raphaeltournafond/STM-Auto/kicad/stm-auto/stm-auto.kicad_sch

## KiCad design kicad/stm-auto/stm-auto.kicad_sch (2026-06-14, an earlier design)

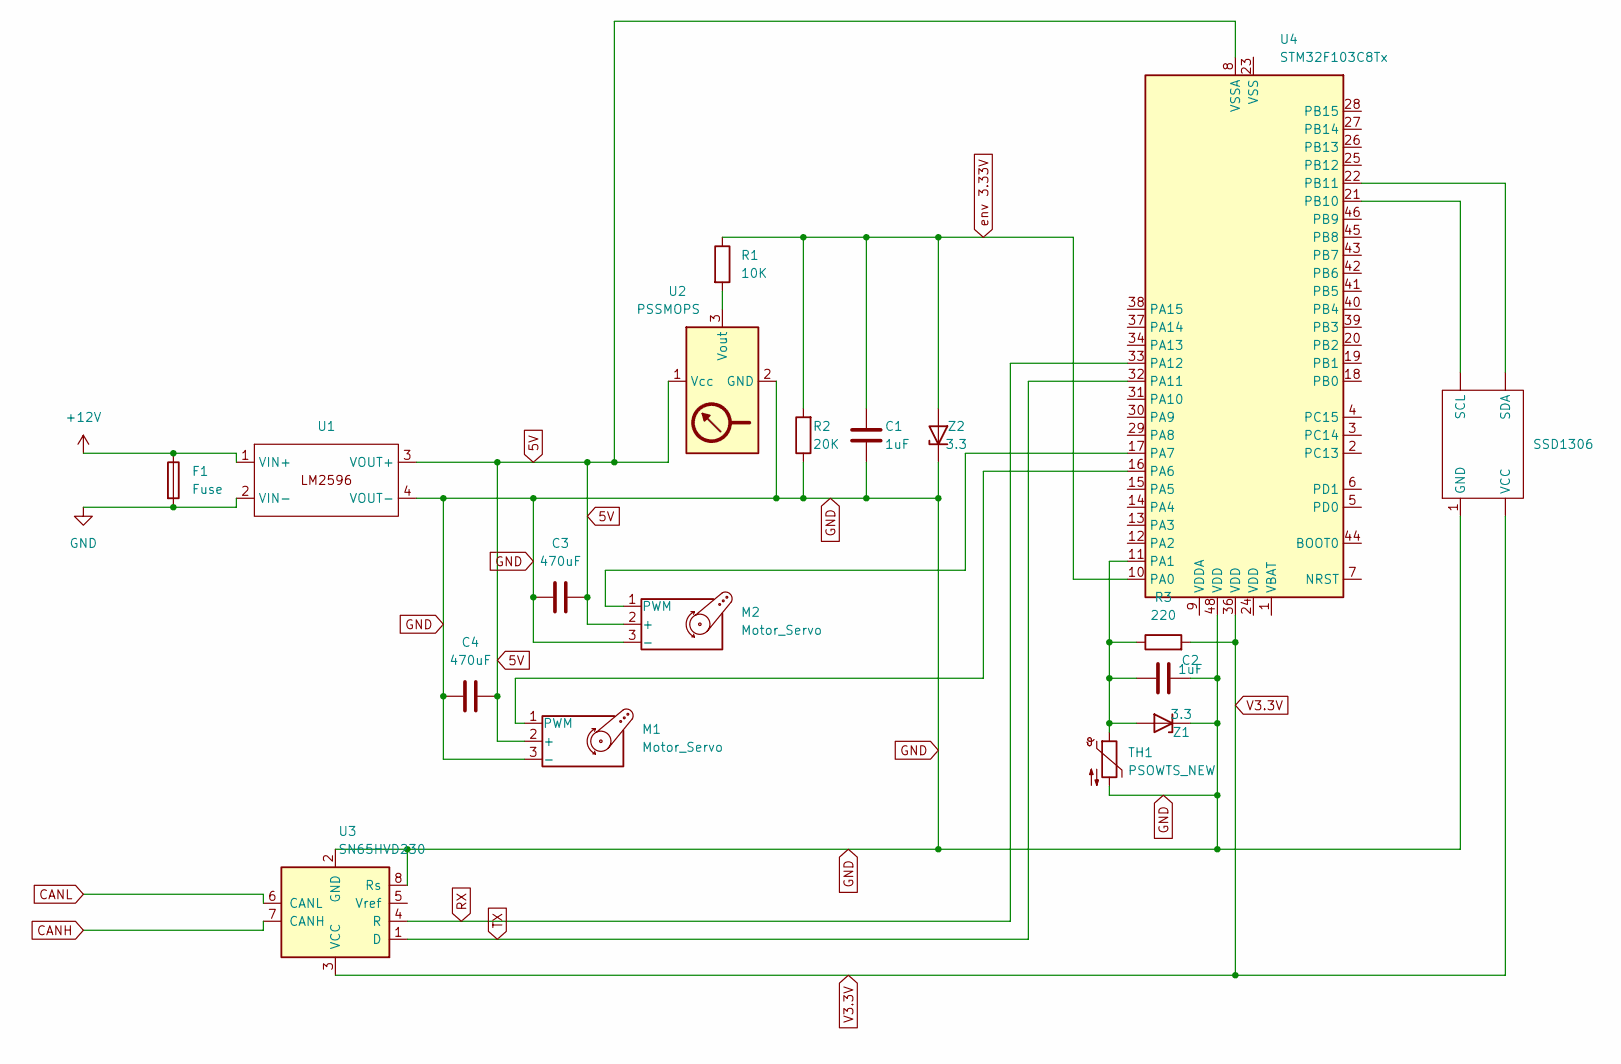
[picture p1: schematic stm-auto.kicad_sch]

Parts:
C1, C2: 1uF
C3, C4: 470uF
F1: Fuse
M1, M2: Motor_Servo
R1: 10K
R2: 20K
R3: 220
SSD1306: (no value)
TH1: PSOWTS_NEW
U1: (no value)
U2: PSSMOPS
U3: SN65HVD230; SOIC-8_3.9x4.9mm_P1.27mm
U4: STM32F103C8Tx; LQFP-48_7x7mm_P0.5mm
Z1, Z2: 3.3

Connections:
5V: C3.2, C4.2, M1.2 (+), M2.2 (+), U1.3 (VOUT+), U2.1 (Vcc), U4.8 (VSSA)
+12V: F1.1, U1.1 (VIN+)
CANH: U3.7 (CANH)
CANL: U3.6 (CANL)
GND: C1.2, C2.2, C3.1, C4.1, F1.2, M1.3 (-), M2.3 (-), R2.1, SSD1306.1 (GND), TH1.2, U1.2 (VIN-), U1.4 (VOUT-), U2.2 (GND), U3.2 (GND), U3.8 (Rs), U4.48 (VDD), Z1.1 (K), Z2.1 (K)
unnamed: C2.1, R3.1, TH1.1, U4.11 (PA1), Z1.2 (A)
unnamed: M1.1 (PWM), U4.16 (PA6)
unnamed: M2.1 (PWM), U4.17 (PA7)
unnamed: R1.2, U2.3 (Vout)
unnamed: SSD1306. (SCL), U4.21 (PB10), U4.22 (PB11)
unnamed: U4.23 (VSS), U4.35 (VSS), U4.47 (VSS)
RX: U3.4 (R), U4.33 (PA12)
TX: U3.1 (D), U4.32 (PA11)
V3.3V: R3.2, SSD1306. (SCL), U3.3 (VCC), U4.36 (VDD)
env 3.33V: C1.1, R1.1, R2.2, U4.10 (PA0), Z2.2 (A)
