raphaeltournafond/STM-Auto/(commit log)

2026-03-04 feat: initializing blink error built in led
    [main.cpp]
2026-03-05 feat: add kicad schematics
    [stm-auto.kicad_pcb, stm-auto.kicad_sch]
2026-03-06 #3 feat!: add temperature calculation
2026-03-10 #12 feat!: add pressure sensor reading
2026-06-12 #8 feat: finalize board pin map and wire main.cpp to pins.h
    - add src/pins.h: complete, conflict-free pin map (single source of truth)
    - main.cpp: include pins.h, drop inline pin constants, use the macros
    - add CLAUDE.md and DECISION_MATRIX.md (behavioural spec)
    - enable clangd LSP (.claude/settings.json); ignore local settings
2026-06-14 #8 feat: drive twin flap servos in tandem
    Both flap servos (PA6/PA7) now open and close together; rename legacy
    red* servo naming to flap* to match pins.h and the decision matrix.
2026-06-14 #8 feat: add flap temperature hysteresis
    Replace single 90C threshold with open-at-92C / close-at-85C hysteresis
    (DECISION_MATRIX §5) to stop flap chatter near the setpoint; display now
    reflects the actual flap state.
    [main.cpp]
2026-06-14 #8 feat: implement situation decision matrix
    Evaluate the priority-ordered situations (DECISION_MATRIX §3) each loop and
    dispatch to outputs: flap (safety-open / overpressure-hold / hysteresis),
    onboard backup LED alert level, edge-triggered sound/voice (stub), and a
    status banner on the OLED. Adds the adaptive low-pressure floor with per-band
    hysteresis (§4). WS2812B colour, buzzer patterns and MP3 voice remain TODO.
    [main.cpp]
2026-06-14 #8 docs: add peripheral wiring decisions and refresh schematic
    Add kicad/stm-auto/WIRING.md capturing the locked wiring choices for the
    WS2812B (diode drop to ~4.3V), buzzer (passive piezo, direct drive), ACK
    touch button (3.3V, PB5 input) and DFPlayer MP3 (5V, SPK speaker). Update
    the schematic and regenerate the SVG. Gitignore the per-user .kicad_prl.
    [stm-auto.kicad_sch]
2026-06-14 test: add native unit-test suite for decision logic
    Extract the pure decision logic (situation matrix §3, flap/low-pressure
    hysteresis §4-§5, interpolation, sensor conversions) out of main.cpp into
    lib/decision/ (Arduino-free, state passed in as parameters) so it can run on
    the host. Add a native PlatformIO env (Unity) and 30 test cases covering
    interpolation edge cases, temperature bands, low-pressure and flap hysteresis,
    priority-ordered situation evaluation, and alert mapping.
    main.cpp now owns hardware I/O + state and calls the pure functions; no
    behaviour change. Both `pio test -e native` (30/30) and the bluepill build pass.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
2026-06-14 ci: bump actions to Node 24 versions
    checkout@v6, setup-python@v6, cache@v5 — silences the Node 20 deprecation
    warning ahead of GitHub forcing Node 24 on 2026-06-16.
2026-06-14 docs: rewrite README for current project state
    Replace the stale temperature-only/single-servo description with the current
    system: dual temp+pressure sensing, twin-servo regulation with hysteresis, the
    situation decision matrix, full pin map, lib/decision architecture, native
    tests + CI, and an accurate implemented/roadmap status. Add CI badge.
2026-06-16 feat: drive WS2812B RGB alert indicator
    Add lib/ws2812 (pure, unit-tested): alertColor() maps the situation alert
    level to off/yellow/red, and encodePixelGRB() encodes one WS2812B pixel into
    9 SPI bytes (3 SPI bits per WS bit, MSB-first, stream ends low for the latch).
    main.cpp transmits over SPI2 MOSI (PB15) with a blocking 9-byte transfer
    (~32us, IRQ-safe, no bit-banging); applyAlertLed() now drives the WS2812B as
    the primary indicator with PC13 as backup. 5 new native tests; docs updated.
2026-06-17 feat: drive buzzer alert patterns
    Add lib/buzzer (pure, unit-tested): buzzerPattern() maps the situation to the
    §3 sound pattern (continuous / intermittent / long-beeps / silent) and
    buzzerOnAt() gives the periodic on/off envelope.
    main.cpp's applyBuzzer() gates tone() on PIN_BUZZER (TIM3) each loop from the
    envelope, tracking state to avoid retriggering. 8 new native tests (43 total);
    docs updated. Voice (MP3) still stubbed.
    [main.cpp]
2026-06-17 feat: acknowledge touch button mutes alerts
    Add lib/ack (pure, unit-tested): updateAck() implements the §6 acknowledge
    state machine — pressing the touch button mutes sound while keeping LED +
    screen, a new higher-priority alert re-arms sound, and the state auto-returns
    to not-acknowledged when no alert is active.
    main.cpp reads PB5 (plain INPUT, rising edge), feeds updateAck() each loop, and
    applyBuzzer() is now muted when acknowledged. 8 new native tests (51 total);
    docs updated.
2026-06-20 feat: MP3 voice prompts on USART1; move debug Serial to USART2
    Add lib/voice (pure, unit-tested): voiceTrack() maps the situation to its §7
    MP3 file, and dfplayerFrame() builds DFPlayer Mini command frames with the
    two's-complement checksum.
    main.cpp drives the DFPlayer over USART1 (HardwareSerial) — plays the prompt on
    situation change and stops it on acknowledge. The Blue Pill variant defaults
    Serial to USART1 (the MP3 pins), so debug Serial is remapped to USART2 (PA2/PA3)
    via build_flags; pins.h/schematic docs add the debug header.
    6 new native tests (56 total); pins.h, CLAUDE.md, README, DECISION_MATRIX and
    WIRING.md updated. Only CAN remains uncoded.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
2026-06-26 feat: BOOT/INIT life phases with self-tests, dual-gauge display, voice & animations
    Startup life phases (DECISION_MATRIX §2): BOOT plays a C-major arpeggio
    (C5-E5-G5-C6) synced with LED blinks, then INIT runs a POST-style checklist of
    blocking self-tests (OLED -> MP3 -> temp -> pressure -> flap cycle). A failed
    check enters enterInitFail (red LED + fault voice + long beeps) which the ACK
    button can bypass. On INIT OK, a gauge sweep animation runs (0 -> 100% -> real
    values; error rows blink instead of sweeping) before RUN.
    Display: SSD1306 layout respects the panel's yellow (y=0-15) / blue (y=16-63)
    physical zones. Yellow strip shows the situation label, inverted on any alert.
    Blue zone sho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
    [main.cpp]
